ValentiWorkLearning/Xilinx-Ant-board/images_silk/990_1.bmp

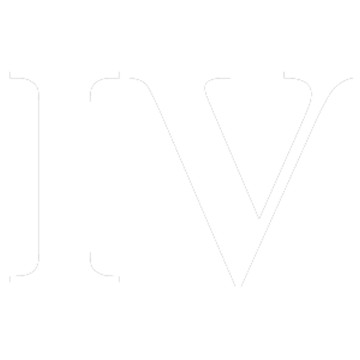
images_silk/990_1.bmp
