ValentiWorkLearning/Xilinx-Ant-board/images_silk/ant.png

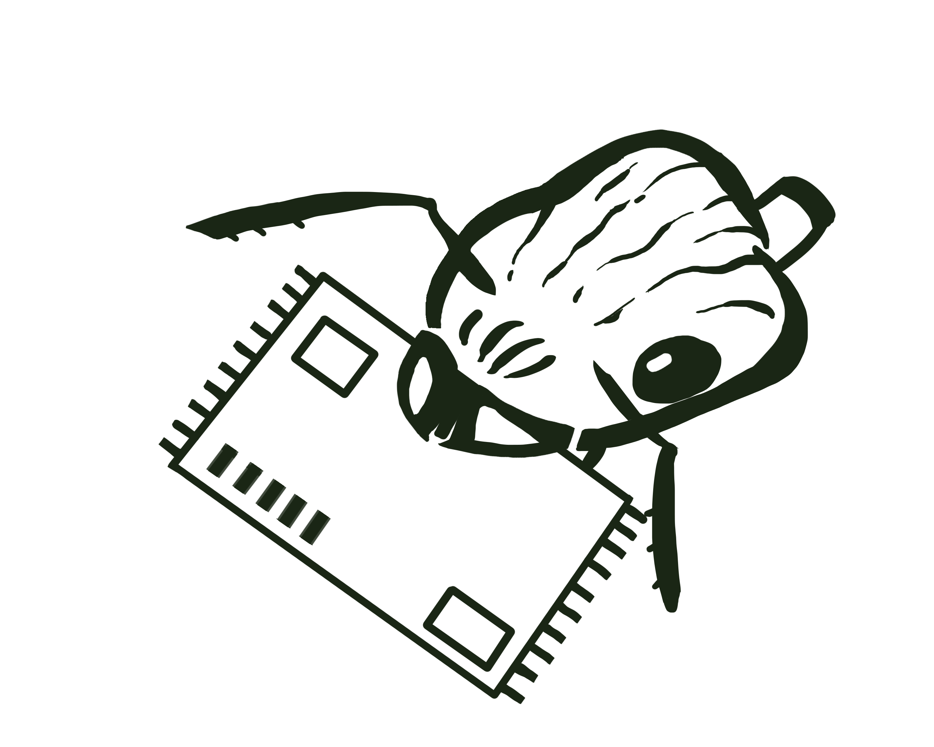
images_silk/ant.png
