ValentiWorkLearning/Xilinx-Ant-board/images_silk/nurev.png

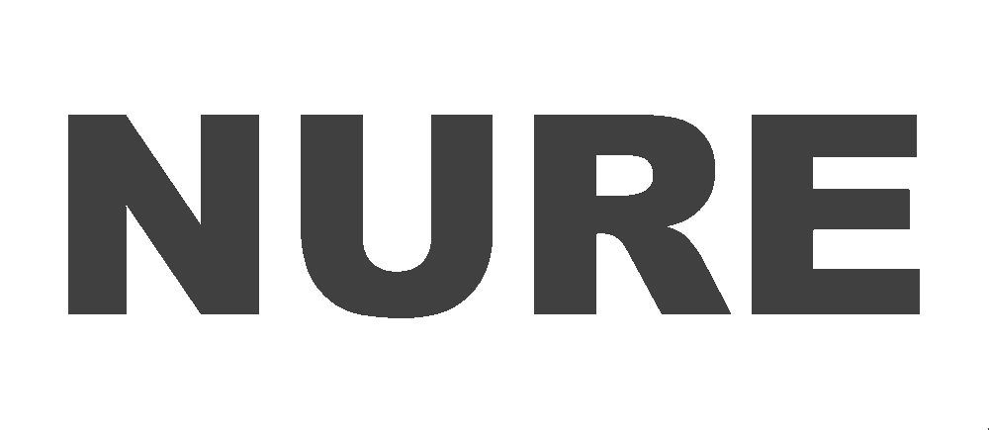
images_silk/nurev.png
