ValentiWorkLearning/Xilinx-Ant-board/images_silk/revv.png

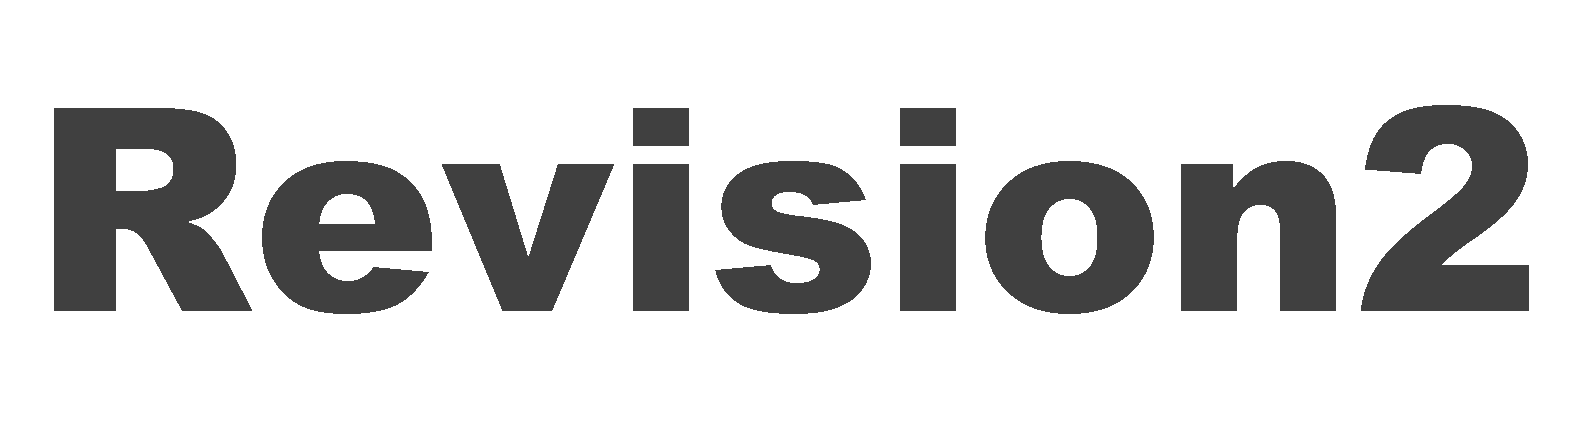
images_silk/revv.png
