ValentiWorkLearning/Xilinx-Ant-board/KiCad_Models/Xtal.STEP

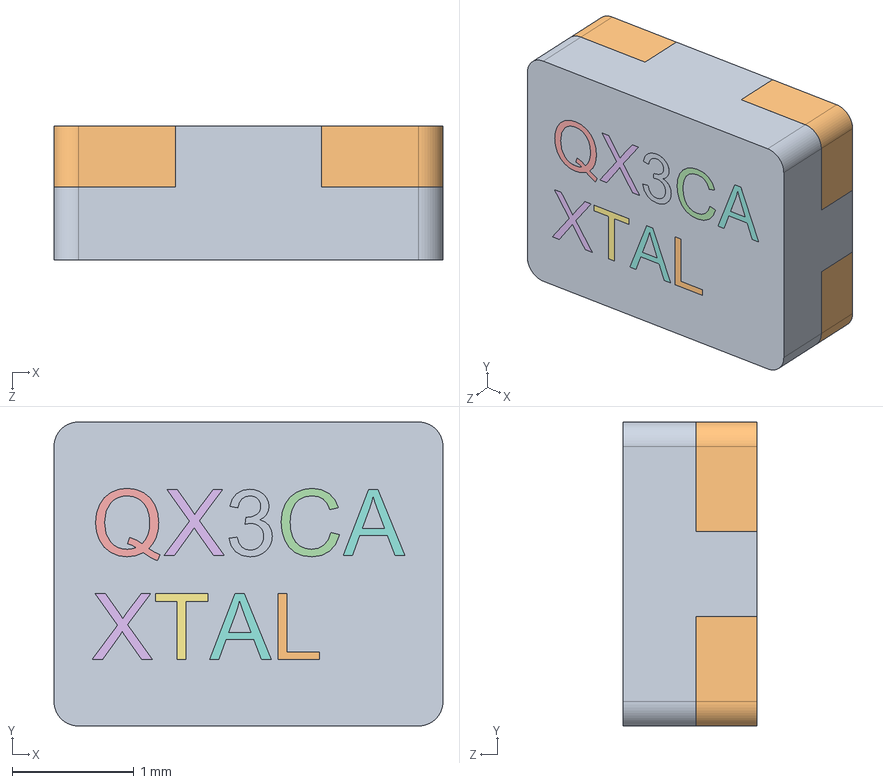
[picture p15: CAD file, 2019-06-23]
KiCad_Models/Xtal.STEP
3.20 x 2.50 x 1.10 mm
User Library-Xtal SMD QUANTEK QX3CA_Body
User Library-Xtal SMD QUANTEK QX3CA_Pin
User Library-Xtal SMD QUANTEK QX3CA_Pin_2
User Library-Xtal SMD QUANTEK QX3CA_Pin_3
User Library-Xtal SMD QUANTEK QX3CA_Pin_4
User Library-Xtal SMD QUANTEK QX3CA_Tekst
