ValentiWorkLearning/Xilinx-Ant-board/Schematic.pdf

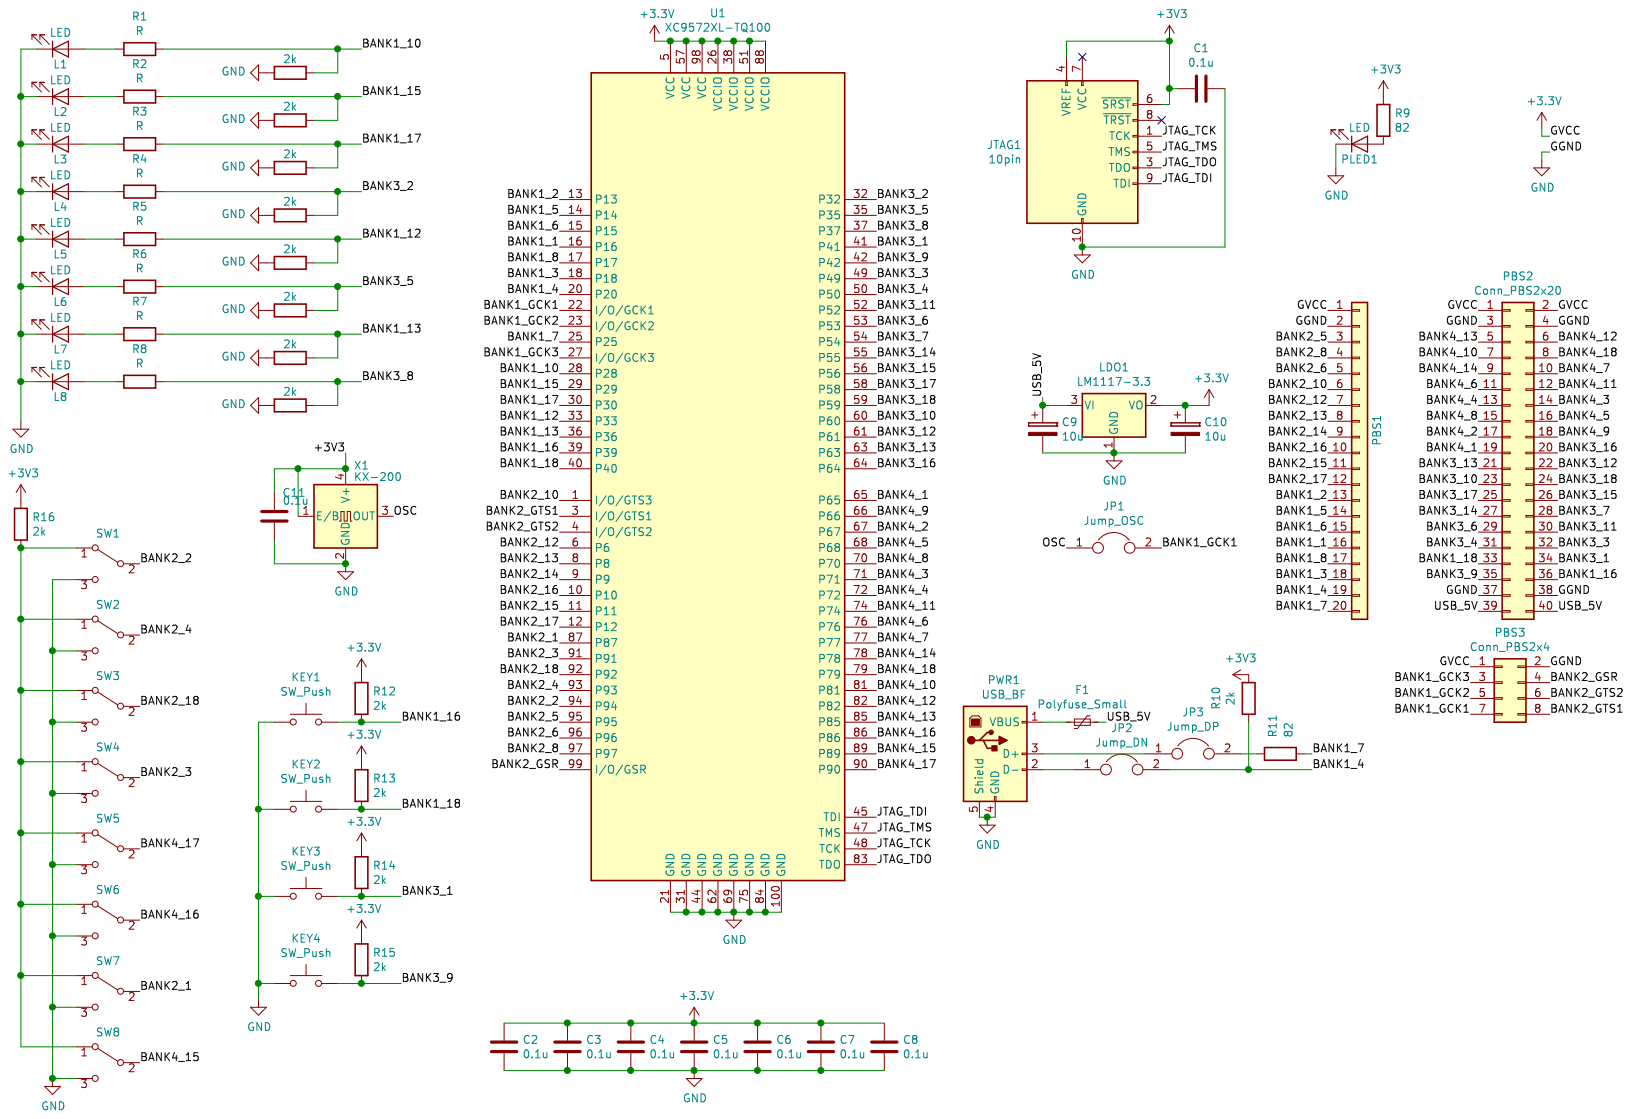
[picture p16: page 1]
