ValentiWorkLearning/Xilinx-Ant-board/cpldxl/cpldxl.kicad_pcb

## KiCad design cpldxl/cpldxl.kicad_pcb (2019-06-25)

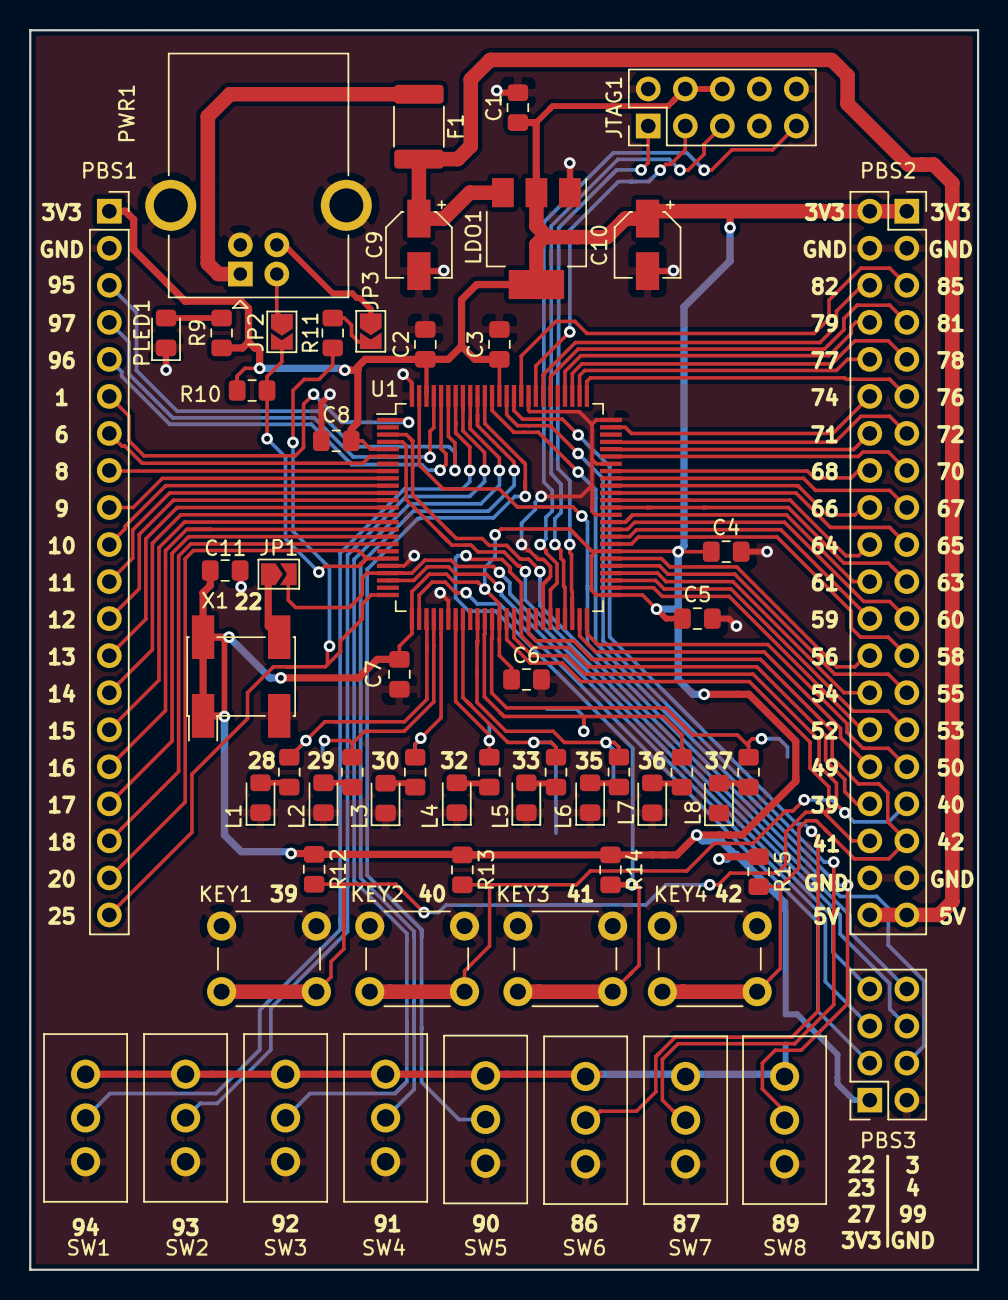
[picture p17: board cpldxl.kicad_pcb from above]

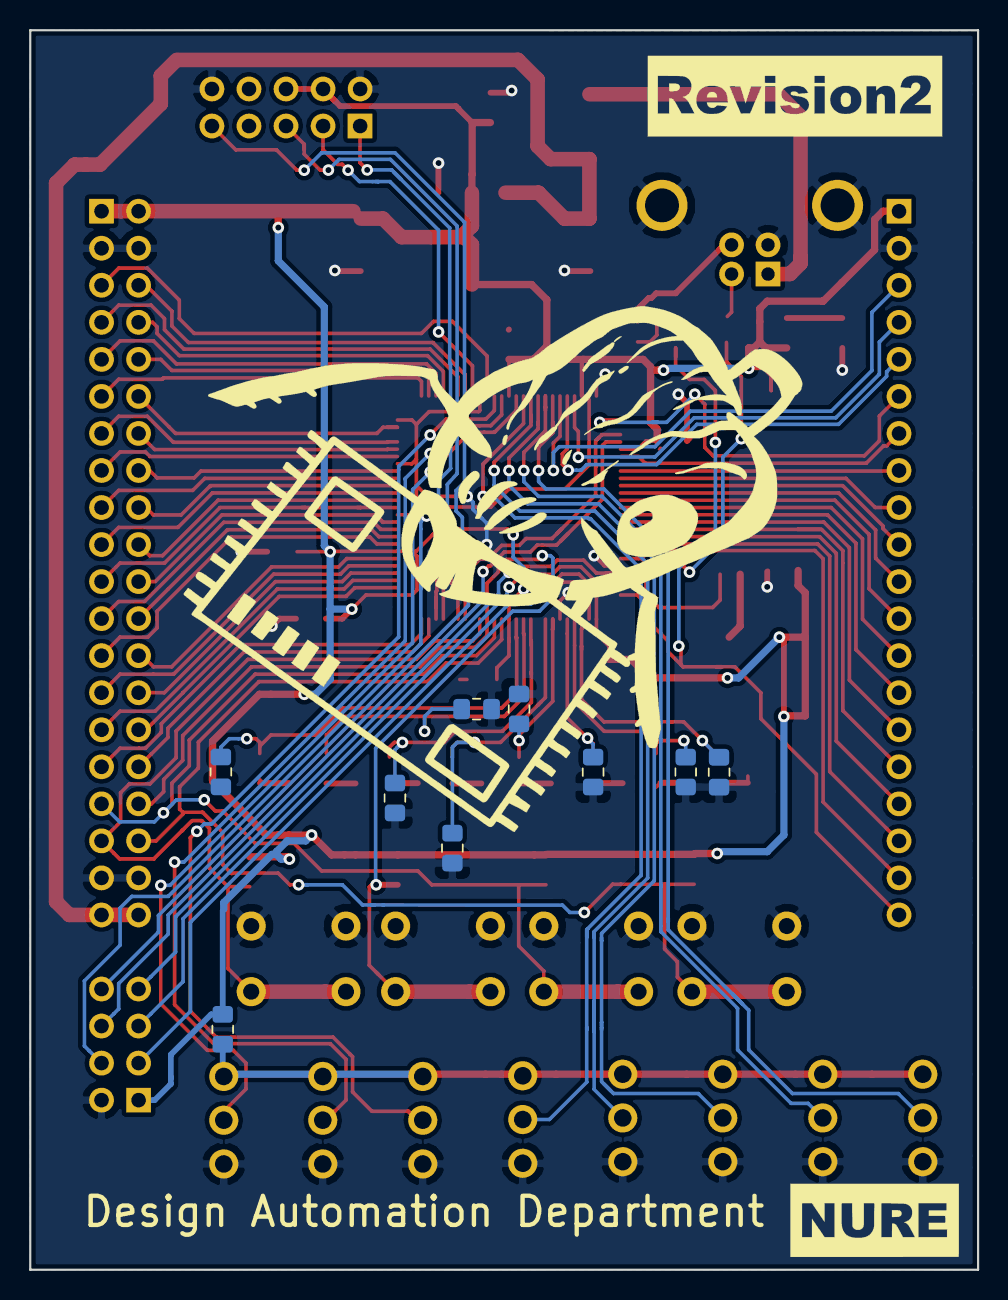
[picture p18: board cpldxl.kicad_pcb from below]

Board: 2 copper layers, 65.0 x 85.0 mm, 68 parts (9 on the bottom side), 94 nets.

Parts:
C1, C2, C3, C4, C5, C6, C7, C8, C11: 0.1u; C_0805_2012Metric_Pad1.15x1.40mm_HandSolder
C9, C10: 10u; CP_Elec_4x4.5
F1: Polyfuse_Small; Fuse_1812_4532Metric_Pad1.30x3.40mm_HandSolder
JP1: Jump_OSC; SolderJumper-2_P1.3mm_Open_TrianglePad1.0x1.5mm
JP2: Jump_DN; SolderJumper-2_P1.3mm_Open_TrianglePad1.0x1.5mm
JP3: Jump_DP; SolderJumper-2_P1.3mm_Open_TrianglePad1.0x1.5mm
JTAG1: 10pin; PinHeader_2x05_P2.54mm_Vertical
KEY1, KEY2, KEY3, KEY4: SW_Push; SW_PUSH_6mm
L1, L2, L3, L4, L5, L6, L7, L8: LED; LED_0805_2012Metric_Pad1.15x1.40mm_HandSolder
LDO1: LM1117-3.3; SOT-223-3_TabPin2
PBS1: Conn_PBS1x25; PinSocket_1x20_P2.54mm_Vertical
PBS2: Conn_PBS2x20; PinSocket_2x20_P2.54mm_Vertical
PBS3: Conn_PBS2x4; PinSocket_2x04_P2.54mm_Vertical
PLED1: LED; LED_0805_2012Metric_Pad1.15x1.40mm_HandSolder
PWR1: USB_BF; USB_B_OST_USB-B1HSxx_Horizontal
R1, R2, R3, R4, R5, R6, R7, R8: R; R_0805_2012Metric_Pad1.15x1.40mm_HandSolder
R9, R11: 82; R_0805_2012Metric_Pad1.15x1.40mm_HandSolder
R10, R12, R13, R14, R15, R16, R17, R18, R19, R20, R21, R22, R23, R24: 2k; R_0805_2012Metric_Pad1.15x1.40mm_HandSolder
SW1, SW2, SW3, SW4, SW5, SW6, SW7, SW8: SW_SPDT; SW_SPDT_SS12N12E (2)
U1: XC9572XL-TQ100; TQFP-100_14x14mm_P0.5mm
X1: KX-200; Oscillator_SMD_Fordahl_DFAS11-4Pin_7.0x5.0mm_HandSoldering

Connections:
+3V3: C1.1, C2.1, C3.1, C4.1, C5.1, C6.1, C7.1, C8.1, C10.1, C11.1, JTAG1.4, JTAG1.6, LDO1.2, PBS1.1, PBS2.1, PBS2.2, PBS3.1, R9.1, R10.1, R12.1, R13.1, R14.1, R15.1, R16.1, U1.5, U1.26, U1.38, U1.51, U1.57, U1.88, U1.98, X1.1, X1.4
/BANK1_1: PBS1.16, U1.16
/BANK1_2: PBS1.13, U1.13
/BANK1_3: PBS1.18, U1.18
/BANK1_4: JP2.2, PBS1.19, R10.2, U1.20
/BANK1_5: PBS1.14, U1.14
/BANK1_6: PBS1.15, U1.15
/BANK1_7: PBS1.20, R11.2, U1.25
/BANK1_8: PBS1.17, U1.17
/BANK1_10: R1.1, R17.1, U1.28
/BANK1_12: R5.1, R21.1, U1.33
/BANK1_13: R7.1, R23.1, U1.36
/BANK1_15: R2.1, R18.1, U1.29
/BANK1_16: KEY1.2, PBS2.36, R12.2, U1.39
/BANK1_17: R3.1, R19.1, U1.30
/BANK1_18: KEY2.2, PBS2.33, R13.2, U1.40
/BANK1_GCK1: JP1.2, PBS3.7, U1.22
/BANK1_GCK2: PBS3.5, U1.23
/BANK1_GCK3: PBS3.3, U1.27
/BANK2_1: SW7.2, U1.87
/BANK2_2: SW1.2, U1.94
/BANK2_3: SW4.2, U1.91
/BANK2_4: SW2.2, U1.93
/BANK2_5: PBS1.3, U1.95
/BANK2_6: PBS1.5, U1.96
/BANK2_8: PBS1.4, U1.97
/BANK2_10: PBS1.6, U1.1
/BANK2_12: PBS1.7, U1.6
/BANK2_13: PBS1.8, U1.8
/BANK2_14: PBS1.9, U1.9
/BANK2_15: PBS1.11, U1.11
/BANK2_16: PBS1.10, U1.10
/BANK2_17: PBS1.12, U1.12
/BANK2_18: SW3.2, U1.92
/BANK2_GSR: PBS3.4, U1.99
/BANK2_GTS1: PBS3.8, U1.3
/BANK2_GTS2: PBS3.6, U1.4
/BANK3_1: KEY3.2, PBS2.34, R14.2, U1.41
/BANK3_2: R4.1, R20.1, U1.32
/BANK3_3: PBS2.32, U1.49
/BANK3_4: PBS2.31, U1.50
/BANK3_5: R6.1, R22.1, U1.35
/BANK3_6: PBS2.29, U1.53
/BANK3_7: PBS2.28, U1.54
/BANK3_8: R8.1, R24.1, U1.37
/BANK3_9: KEY4.2, PBS2.35, R15.2, U1.42
/BANK3_10: PBS2.23, U1.60
/BANK3_11: PBS2.30, U1.52
/BANK3_12: PBS2.22, U1.61
/BANK3_13: PBS2.21, U1.63
/BANK3_14: PBS2.27, U1.55
/BANK3_15: PBS2.26, U1.56
/BANK3_16: PBS2.20, U1.64
/BANK3_17: PBS2.25, U1.58
/BANK3_18: PBS2.24, U1.59
/BANK4_1: PBS2.19, U1.65
/BANK4_2: PBS2.17, U1.67
/BANK4_3: PBS2.14, U1.71
/BANK4_4: PBS2.13, U1.72
/BANK4_5: PBS2.16, U1.68
/BANK4_6: PBS2.11, U1.76
/BANK4_7: PBS2.10, U1.77
/BANK4_8: PBS2.15, U1.70
/BANK4_9: PBS2.18, U1.66
/BANK4_10: PBS2.7, U1.81
/BANK4_11: PBS2.12, U1.74
/BANK4_12: PBS2.6, U1.82
/BANK4_13: PBS2.5, U1.85
/BANK4_14: PBS2.9, U1.78
/BANK4_15: SW8.2, U1.89
/BANK4_16: SW6.2, U1.86
/BANK4_17: SW5.2, U1.90
/BANK4_18: PBS2.8, U1.79
/JTAG_TCK: JTAG1.1, U1.48
/JTAG_TDI: JTAG1.9, U1.45
/JTAG_TDO: JTAG1.3, U1.83
/JTAG_TMS: JTAG1.5, U1.47
/OSC: JP1.1, X1.3
/USB_5V: C9.1, F1.1, LDO1.3, PBS2.39, PBS2.40
GND: C1.2, C2.2, C3.2, C4.2, C5.2, C6.2, C7.2, C8.2, C9.2, C10.2, C11.2, JTAG1.2, JTAG1.10, KEY1.1, KEY2.1, KEY3.1, KEY4.1, L1.1, L2.1, L3.1, L4.1, L5.1, L6.1, L7.1, L8.1, LDO1.1, PBS1.2, PBS2.3, PBS2.4, PBS2.37, PBS2.38, PBS3.2, PLED1.1, PWR1.4, PWR1.5, R17.2, R18.2, R19.2, R20.2, R21.2, R22.2, R23.2, R24.2, SW1.3, SW2.3, SW3.3, SW4.3, SW5.3, SW6.3, SW7.3, SW8.3, U1.21, U1.31, U1.44, U1.62, U1.69, U1.75, U1.84, U1.100, X1.2
unnamed: F1.2, PWR1.1
unnamed: JP2.1, PWR1.2
unnamed: JP3.1, PWR1.3
unnamed: JP3.2, R11.1
unnamed: L1.2, R1.2
unnamed: L2.2, R2.2
unnamed: L3.2, R3.2
unnamed: L4.2, R4.2
unnamed: L5.2, R5.2
unnamed: L6.2, R6.2
unnamed: L7.2, R7.2
unnamed: L8.2, R8.2
unnamed: PLED1.2, R9.2
unnamed: R16.2, SW1.1, SW2.1, SW3.1, SW4.1, SW5.1, SW6.1, SW7.1, SW8.1
