ValentiWorkLearning/Xilinx-Ant-board/(commit log)

2019-06-23 Updated schematic
2019-06-25 Fixed bank 1.18 vias position
    [cpldxl.kicad_pcb]
2019-09-13 Added board description
